pajrigithub/ESP32-S3-Mini-Camera/Schematic/Schematic MIniCam ESP32.png

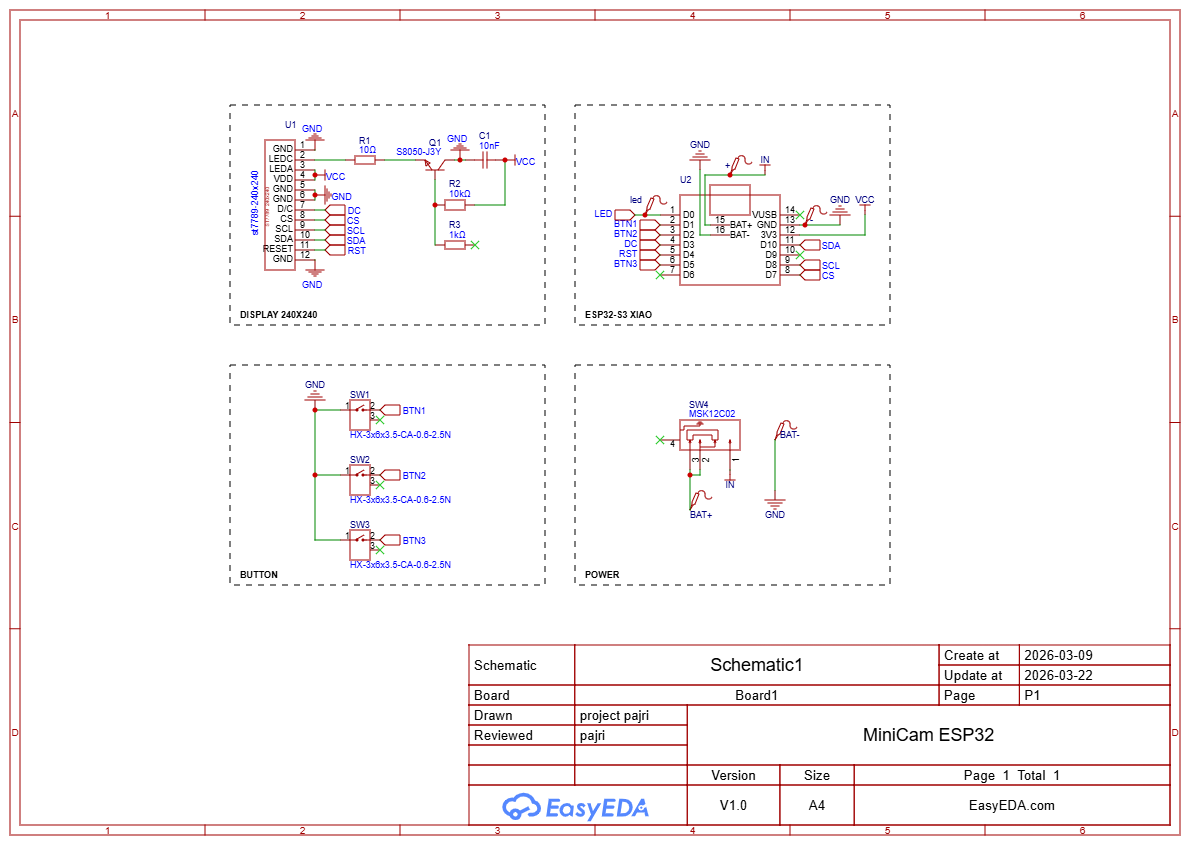
Schematic/Schematic MIniCam ESP32.png
